ABPaterson/Online-arduino-app/sherp-n1200-model/reference/sherpaustralia_n1200_dimensions.jpg

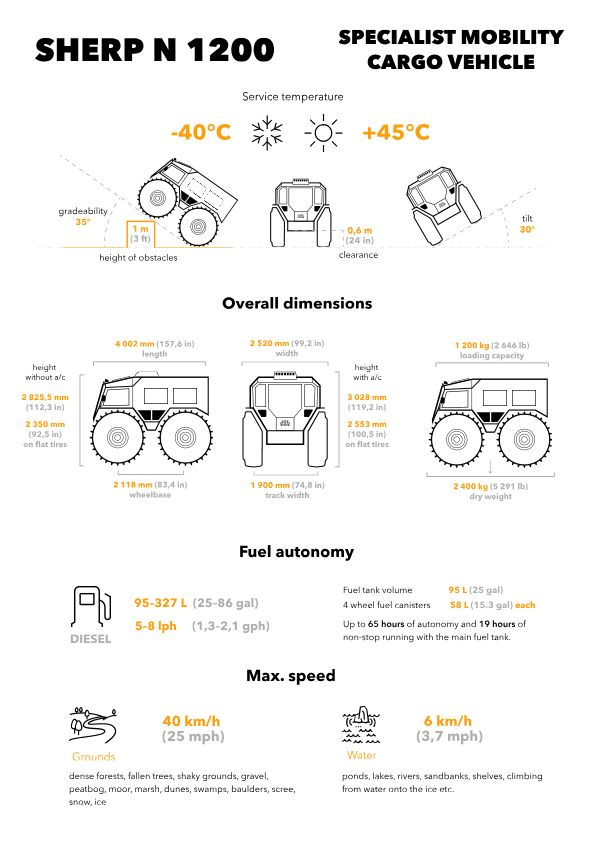
sherp-n1200-model/reference/sherpaustralia_n1200_dimensions.jpg
