ABPaterson/Online-arduino-app/sherp-n1200-model/renders/front.png

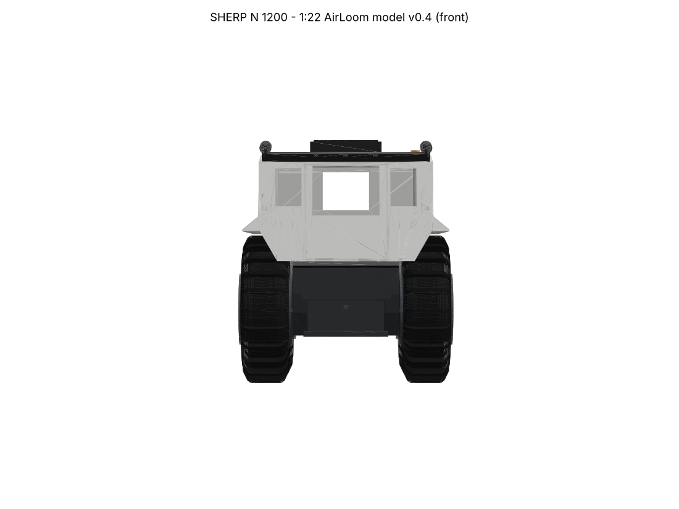
sherp-n1200-model/renders/front.png
