ABPaterson/Online-arduino-app/sherp-n1200-model/3mf/SHERP N1200 v0.4 - ASSEMBLED view only.3mf

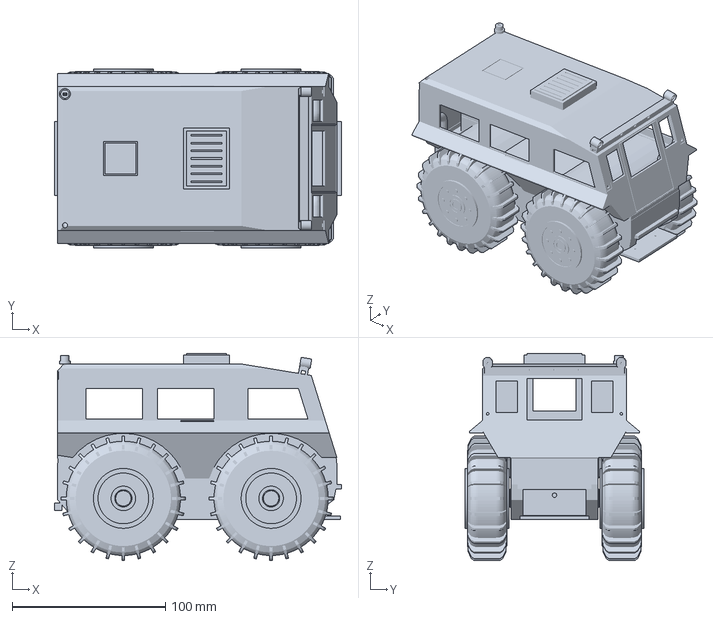
[picture p9: CAD file, 2026-11-09]
sherp-n1200-model/3mf/SHERP N1200 v0.4 - ASSEMBLED view only.3mf
187.0 x 116.7 x 135.1 mm
