ABPaterson/Online-arduino-app/sherp-n1200-model/stl/02_cab_print_roof_down.stl

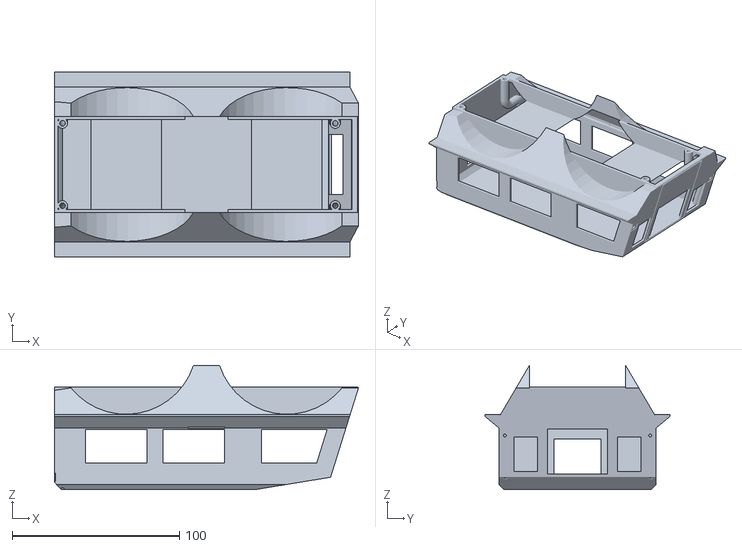
[picture p10: CAD file, 2026-11-09]
sherp-n1200-model/stl/02_cab_print_roof_down.stl
182.0 x 111.0 x 74.4
