ABPaterson/Online-arduino-app/sherp-n1200-model/3mf/SHERP N1200 v0.4 - A1 project (3 plates, PLA + TPU).3mf

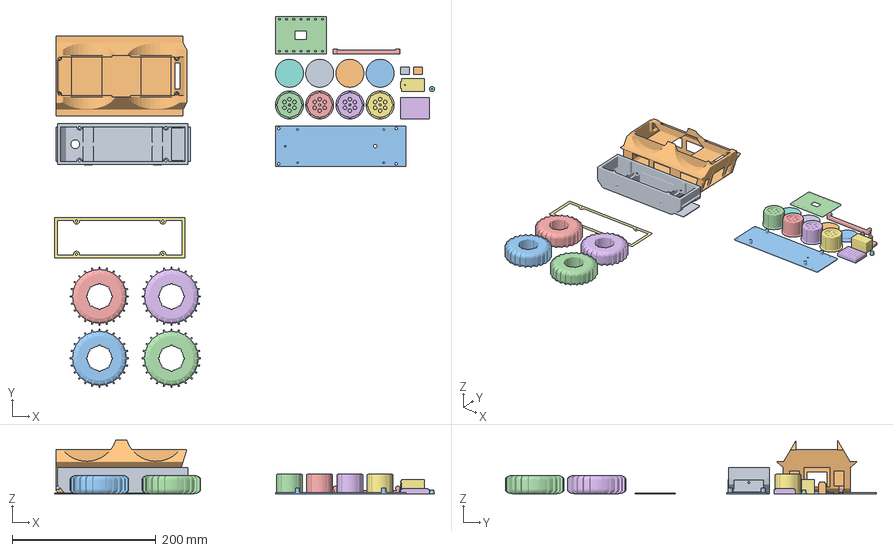
[picture p11: CAD file, 2026-11-09]
sherp-n1200-model/3mf/SHERP N1200 v0.4 - A1 project (3 plates, PLA + TPU).3mf
528.4 x 515.6 x 74.4 mm
Hull tub
Cab (roof down)
Deck lid
Wheel hub 1
Wheel hub 2
Wheel hub 3
Wheel hub 4
Wheel cap 1
Wheel cap 2
Wheel cap 3
Wheel cap 4
Electronics tray
Roof light bar
Roof aircon
Fridge
Beacon
Seat 1
Seat 2
Tyre 1
Tyre 2
Tyre 3
Tyre 4
Gasket
