ABPaterson/Online-arduino-app/sherp-n1200-model/stl/03_deck_lid.stl

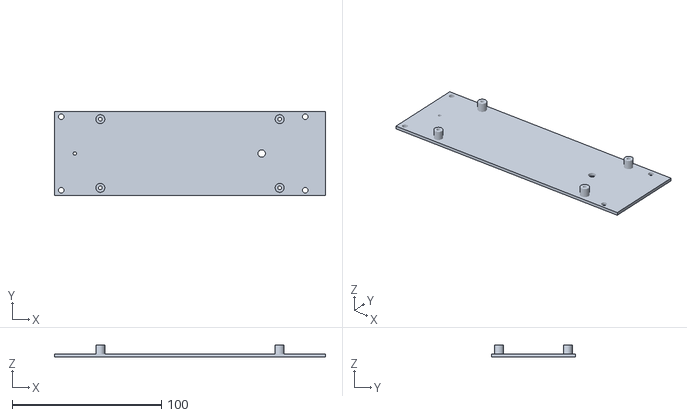
[picture p12: CAD file, 2026-11-09]
sherp-n1200-model/stl/03_deck_lid.stl
181.4 x 56.4 x 8.00
