ABPaterson/Online-arduino-app/sherp-n1200-model/stl/01_hull_tub_print_floor_down.stl

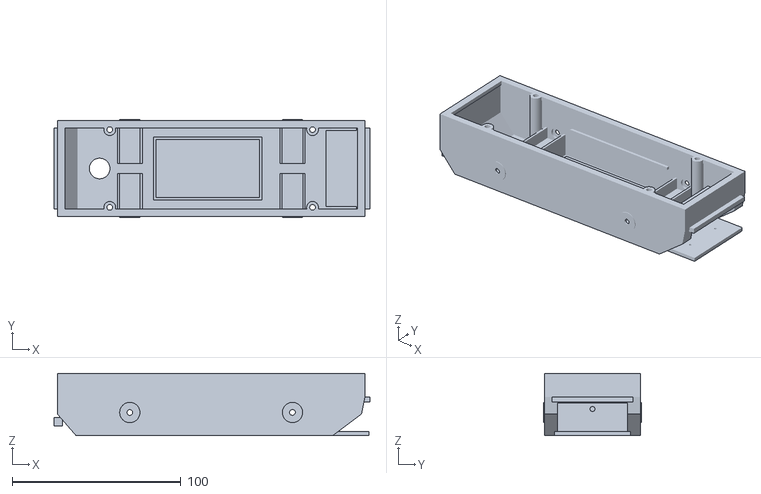
[picture p13: CAD file, 2026-11-07]
sherp-n1200-model/stl/01_hull_tub_print_floor_down.stl
187.0 x 58.0 x 36.7
