ABPaterson/Online-arduino-app/sherp-n1200-model/stl/07_wheel_cap_x4.stl

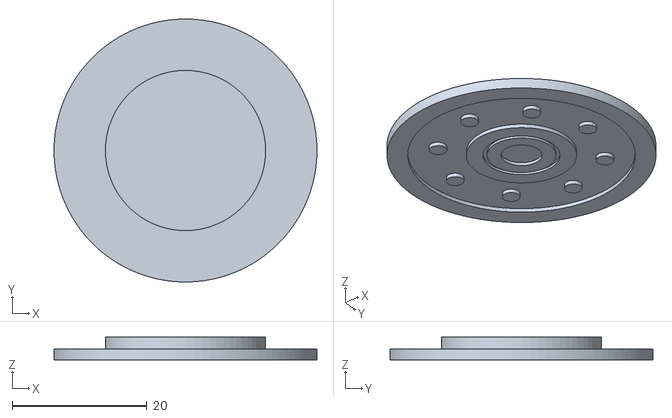
[picture p14: CAD file, 2026-11-07]
sherp-n1200-model/stl/07_wheel_cap_x4.stl
39.0 x 39.0 x 3.40
