ABPaterson/Online-arduino-app/sherp-n1200-model/stl/06_tyre_x4_TPU.stl

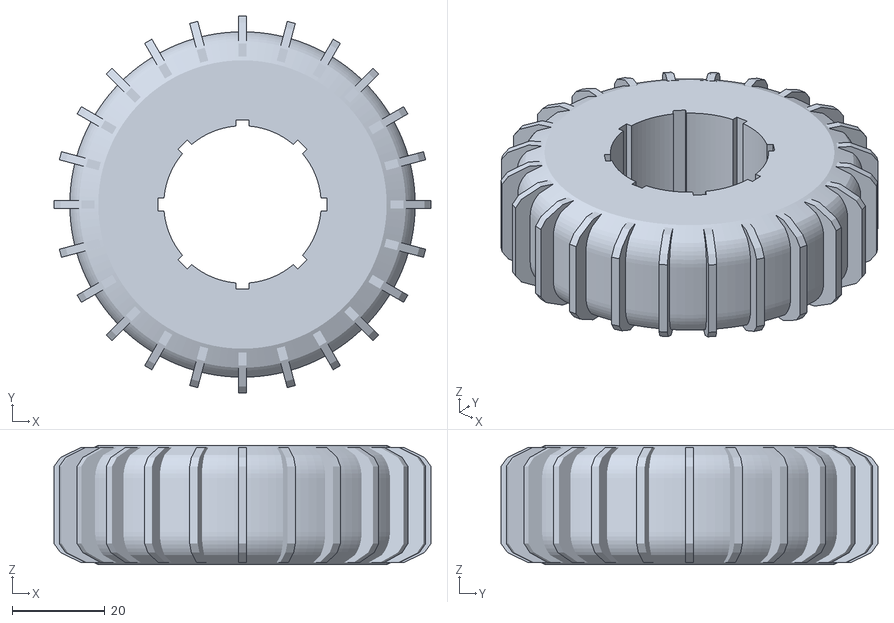
[picture p15: CAD file, 2026-11-07]
sherp-n1200-model/stl/06_tyre_x4_TPU.stl
81.2 x 81.2 x 25.7
