ABPaterson/Online-arduino-app/sherp-n1200-model/stl/08_roof_light_bar.stl

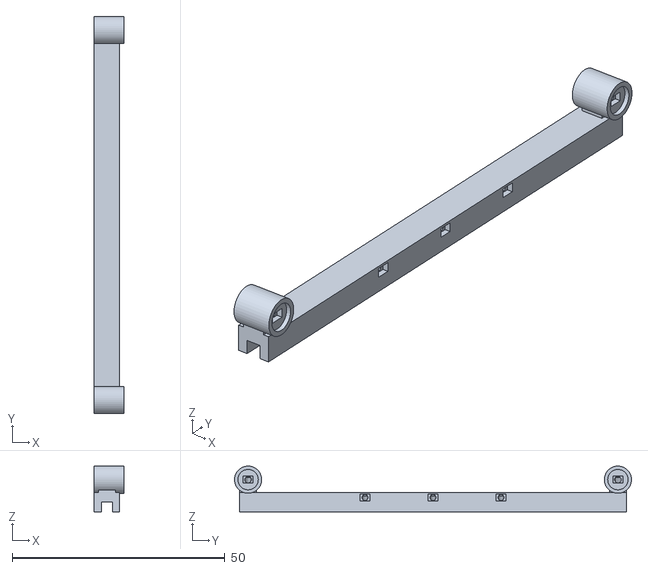
[picture p16: CAD file, 2026-11-07]
sherp-n1200-model/stl/08_roof_light_bar.stl
7.00 x 93.4 x 10.8
