ABPaterson/Online-arduino-app/sherp-n1200-model/stl/10_beacon.stl

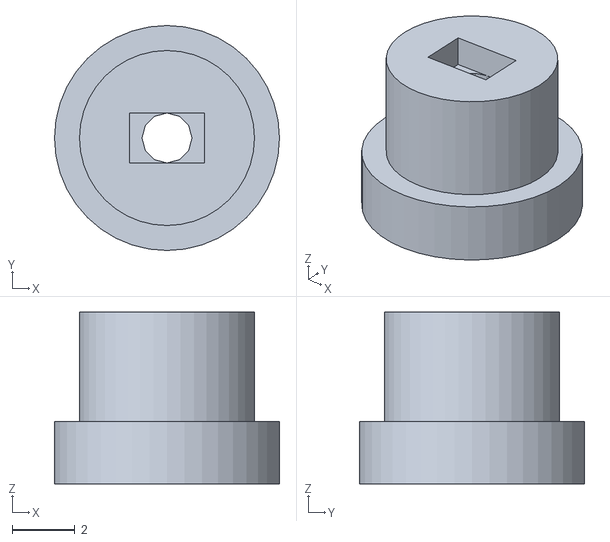
[picture p17: CAD file, 2026-11-07]
sherp-n1200-model/stl/10_beacon.stl
7.20 x 7.20 x 5.50
