ABPaterson/Online-arduino-app/sherp-n1200-model/stl/09_roof_aircon.stl

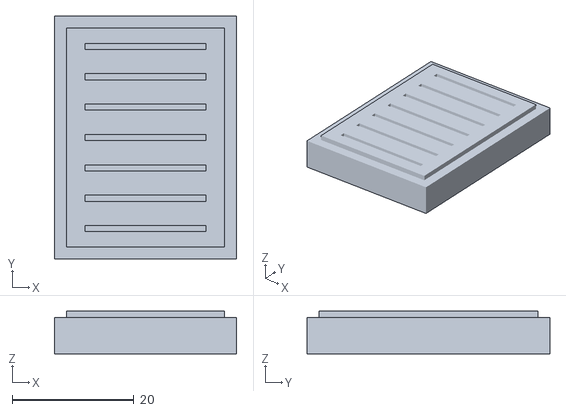
[picture p18: CAD file, 2026-11-07]
sherp-n1200-model/stl/09_roof_aircon.stl
30.0 x 40.0 x 7.00
