ABPaterson/Online-arduino-app/sherp-n1200-model/stl/11_fridge.stl

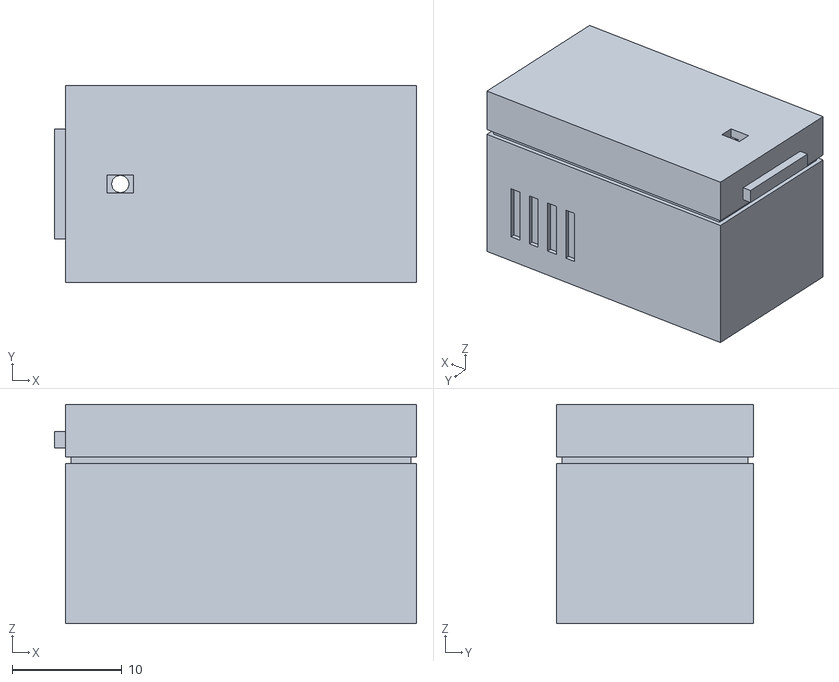
[picture p19: CAD file, 2026-11-07]
sherp-n1200-model/stl/11_fridge.stl
33.0 x 18.0 x 20.0
