ABPaterson/Online-arduino-app/sherp-n1200-model/stl/04_gasket_TPU.stl

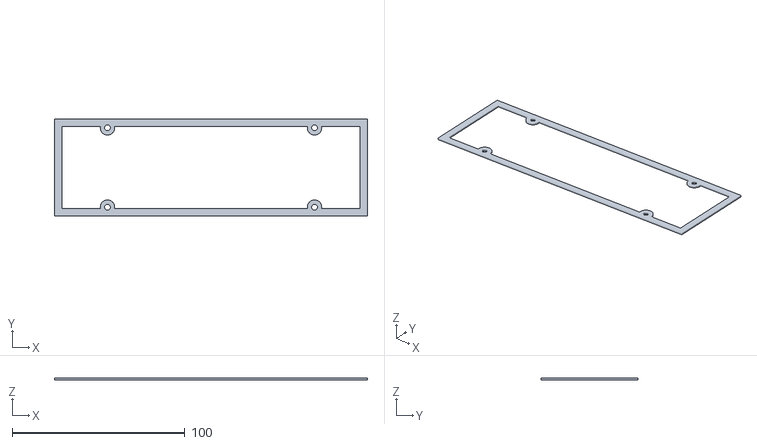
[picture p20: CAD file, 2026-11-07]
sherp-n1200-model/stl/04_gasket_TPU.stl
181.4 x 56.4 x 1.00
