ABPaterson/Online-arduino-app/sherp-n1200-model/stl/05_wheel_hub_x4.stl

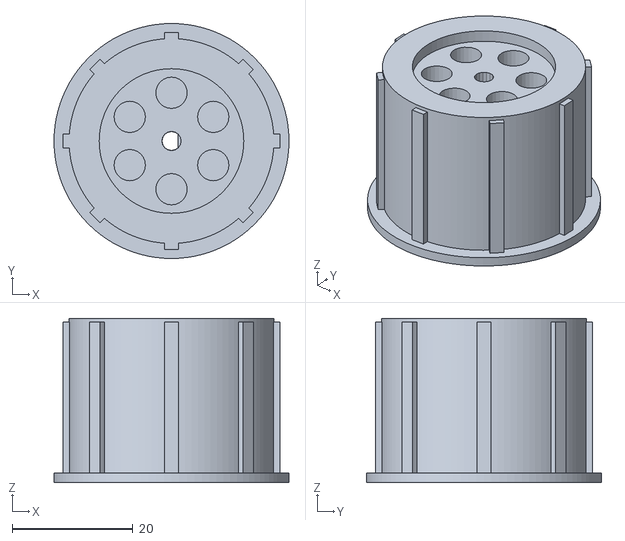
[picture p21: CAD file, 2026-11-07]
sherp-n1200-model/stl/05_wheel_hub_x4.stl
39.0 x 39.0 x 27.3
