ABPaterson/Online-arduino-app/sherp-n1200-model/stl/13_electronics_tray.stl

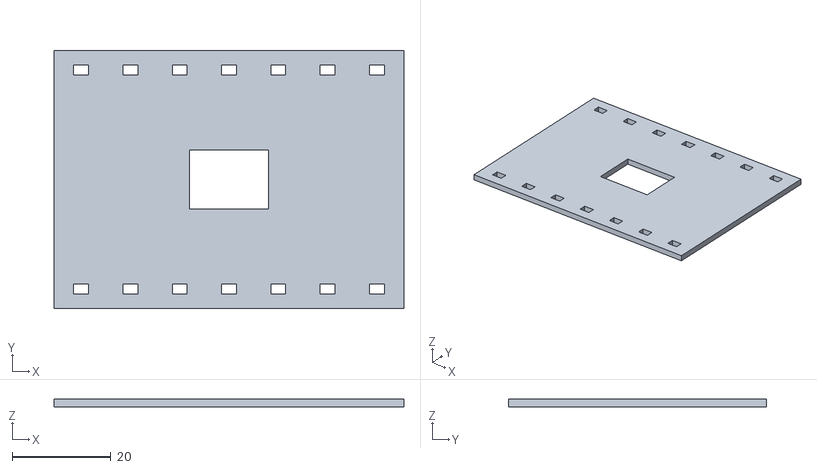
[picture p22: CAD file, 2026-11-07]
sherp-n1200-model/stl/13_electronics_tray.stl
71.0 x 52.4 x 1.60
