ABPaterson/Online-arduino-app/sherp-n1200-model/stl/12_seat_x2.stl

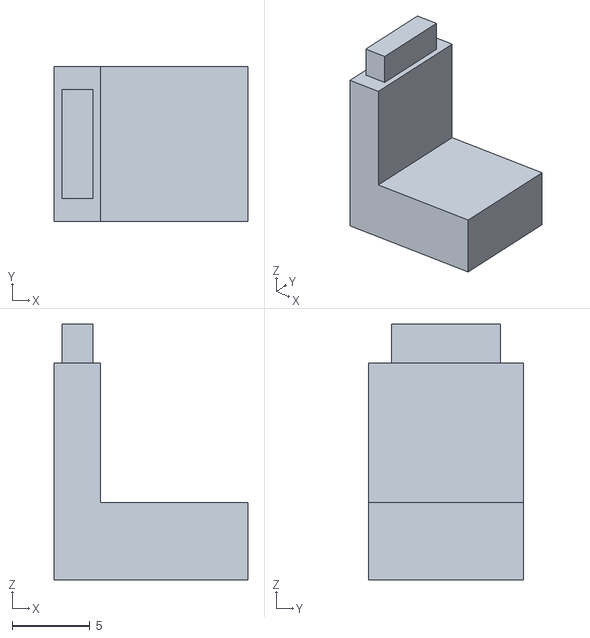
[picture p23: CAD file, 2026-11-07]
sherp-n1200-model/stl/12_seat_x2.stl
12.5 x 10.0 x 16.5
