ABPaterson/Online-arduino-app/(list of files, cad)

Other CAD files:
sherp-n1200-model/stl/00_assembled_preview_DO_NOT_PRINT.stl
