ABPaterson/Online-arduino-app/(commit log)

2026-11-07 Add SHERP N 1200 1:22 AirLoom demo model v0.1 (printable draft)
    Parametric generator (manifold3d) producing support-free STLs for hull,
    cabin shell, removable belly plate, wheels, light bar, beacon, fridge and
    seats. Includes hidden wiring ducts for roof lights, LED pockets for head,
    tail, spot, bar, beacon and fridge lights, winch fairlead and servo mount,
    USB-C charge port, ESP32-C3 SuperMini bay, renders, parts list and a bench
    test sketch.
    Claude-Session: https://claude.ai/code/session_019w94mBumJp5YzkfZZxP9Pe
    [00_assembled_preview_DO_NOT_PRINT.stl, 01_hull_print_deck_down.stl, 02_cabin_print_roof_down.stl, 03_belly_plate.stl, 04_wheel_x4.stl, 05_lightbar_print_groove_up.stl, 06_beacon.stl, 07_fridge.stl]
2026-11-07 SHERP N1200 model v0.2: TPU/PLA wheels, roof light conduits, A1 3MF plates
    - Wheels split into PLA hub (keyed) + TPU 95A tyre + PLA cap, no filament
    changes needed
    - Roof light rack (light bar + spotlights) wired through under-roof
    conduits with 5/8 mm bends down thickened B-pillars; bumper spots removed
    - 3MF plate files laid out for the Bambu A1 bed, one filament per plate
    - README: AliExpress parts list, wiring, assembly
    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
    [00_assembled_preview_DO_NOT_PRINT.stl, 01_hull_print_deck_down.stl, 02_cabin_print_roof_down.stl, 04_wheel_hub_x4_PLA.stl, 04_wheel_x4.stl, 05_lightbar_print_groove_up.stl, 05_tyre_x4_TPU.stl, 06_wheel_cap_x4_PLA.stl]
2026-11-07 SHERP N1200 model v0.3: photo-matched body, sealed floating RC hull
    - Body reshaped from the SHERP N 1200 spec sheet and photos: wide cab over
    the tyres, narrow hull, front door/windscreen, corner-pod headlights,
    roof A/C, light bar with spotlights, rear work lights, beacon
    - Sealed hull tub with removable cab (deck lid + TPU gasket, 4 x M3 from
    underneath), 4 x N20 drive motor cradles with O-ring shaft seals,
    flooded bow winch pocket, latching power button through the floor
    - Wheels: D-bore hubs for N20 shafts, deeper chevron paddle tyres
    - Float check (mass estimate vs displacement) built into the generator
    - Bambu Studio project 3MF with flattened official A1/PLA/TPU profiles
    - RE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
    [00_assembled_preview_DO_NOT_PRINT.stl, 01_hull_print_deck_down.stl, 01_hull_tub_print_floor_down.stl, 02_cab_print_roof_down.stl, 02_cabin_print_roof_down.stl, 03_belly_plate.stl, 03_deck_lid.stl, 04_gasket_TPU.stl]
2026-11-07 SHERP N1200 model v0.4: body redrawn from the spec-sheet drawing
    - Wheels now sit in the body: deep wheel arches, flared fender ledges over
    the tyres, lower cab sides angled in to the hull, vent panel dipping
    between the wheels, nose/tail down to ~1.5 m
    - Cab width corrected to ~82 % of overall width, front door face raked
    ~20 deg with corner windows, track corrected to ~88 mm
    - Conduits re-routed along the raked front corners and over the fenders
    - Renderer depth-sorts all faces together; added drawing-vs-model sheet
    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
    [00_assembled_preview_DO_NOT_PRINT.stl, 01_hull_tub_print_floor_down.stl, 02_cab_print_roof_down.stl, 03_deck_lid.stl, 08_roof_light_bar.stl, SHERP N1200 v0.3 - A1 project (3 plates, PLA + TPU).3mf, SHERP N1200 v0.3 - ASSEMBLED view only.3mf, SHERP N1200 v0.4 - A1 project (3 plates, PLA + TPU).3mf]
2026-11-07 SHERP N1200 model: real SHERP paddle tyres
    Tyre rebuilt from photos: round balloon carcass with 24 straight paddle
    blades across the tread that run down the shoulders as pointed teeth;
    wheel cap gets the concentric rings of the real wheel disc.
    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
    [00_assembled_preview_DO_NOT_PRINT.stl, 06_tyre_x4_TPU.stl, 07_wheel_cap_x4.stl, SHERP N1200 v0.4 - A1 project (3 plates, PLA + TPU).3mf, SHERP N1200 v0.4 - ASSEMBLED view only.3mf]
2026-11-07 SHERP N1200 model: EY RC 1:24 metal winch
    Bow pocket resized for the EY RC 1:24 all-metal winch (38.3 mm wide)
    with a bumper tray and 2 x M2 mounting holes; front step raised above
    it. Winch driven by a third TB6612 fed from the 5 V rail (RC winches run
    at ~4.8-6 V). Parts list and pin map updated. Hull seal re-verified.
    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
    [00_assembled_preview_DO_NOT_PRINT.stl, 01_hull_tub_print_floor_down.stl, SHERP N1200 v0.4 - A1 project (3 plates, PLA + TPU).3mf, SHERP N1200 v0.4 - ASSEMBLED view only.3mf]
2026-11-09 SHERP N1200 model: front roof batter matching the spec drawing
    - Front quarter of the roof slopes ~9 deg down to the windscreen; light
    bar tilted to sit on it
    - Front face rake ~17 deg, side windows lowered, fender trimmed to suit
    - Cab object in the Bambu project gets tree supports (build plate only)
    for the sloped roof section
    - bambu_3mf: per-object settings support
    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
    [00_assembled_preview_DO_NOT_PRINT.stl, 02_cab_print_roof_down.stl, 03_deck_lid.stl, SHERP N1200 v0.4 - A1 project (3 plates, PLA + TPU).3mf, SHERP N1200 v0.4 - ASSEMBLED view only.3mf]
2026-11-09 SHERP N1200 model: rebuild drawing-vs-model comparison on every run
    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
    [SHERP N1200 v0.4 - A1 project (3 plates, PLA + TPU).3mf, SHERP N1200 v0.4 - ASSEMBLED view only.3mf]
